0x007E/rcl/mechanical/housing.FCStd

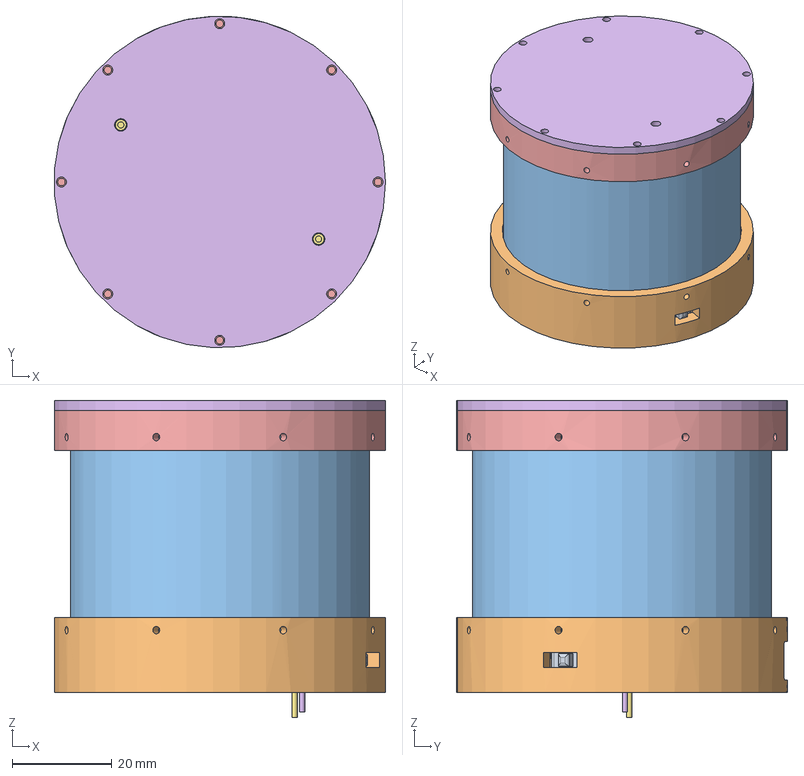
[picture p1: CAD file, 2026-05-14]
mechanical/housing.FCStd
66.3 x 66.3 x 63.5 mm
Pcb_e179
U2_SOT_563_2dd8ecf5d5b2
C7_C_1206_3216Metric_b50edff72533
D17_LED_RGB_5050_6_446c280b42f4
R8_R_1206_3216Metric_683208ab82f3
R7_R_1206_3216Metric_c8e4829b0dbe
R20_R_1206_3216Metric_ada6986ab1e3
U4_SOIC_14_39x87mm_P127mm_a823e2dd6a96
R6_R_1206_3216Metric_a43521a23db1
D8_LED_1206_3216Metric_441c9a4e21c6
R22_R_1206_3216Metric_ec401104cd5b
R2_R_1206_3216Metric_38918280b1d4
J3_PinSocket_1x05_P254mm_Vertical_10db449187f2
D10_LED_RGB_5050_6_a057058c2c85
D14_LED_RGB_5050_6_f9c46359ebbe
C5_CP_EIA_6032_28_Kemet_C_9ff8ca105aa5
C6_CP_EIA_6032_28_Kemet_C_5cea3e5c8aeb
D9_LED_1206_3216Metric_51ed994f9992
U1_MSOP_10_3x3mm_P05mm_71ae01295b95
D3_LED_1206_3216Metric_cbb3f32ba383
D16_LED_RGB_5050_6_b71b78d54b77
D15_LED_RGB_5050_6_33237c4f53fe
R26_R_1206_3216Metric_9c2edd1c9367
D7_LED_1206_3216Metric_bb91850a56bd
D12_LED_RGB_5050_6_03ddc8fedd98
R1_R_1206_3216Metric_1c8ffaa0bde6
D11_LED_RGB_5050_6_1851560dca97
C8_CP_EIA_6032_28_Kemet_C_c15ccf4b1ffd
Pins
Pins001
Sealant
wire
wire001
R3_R_1206_3216Metric_5ddc5bbf8b34
D13_LED_RGB_5050_6_6a2bdbbd2506
D2_D_MiniMELF_Standard_6b93bcc5f046
R27_R_1206_3216Metric_52032e25f07e
F2_Fuse_1206_3216Metric_555ae69b6f8a
C13_C_1206_3216Metric_f1310714ac0f
R25_R_1206_3216Metric_a714514fdd53
R5_R_1206_3216Metric_4461fe18ce72
C10_C_1206_3216Metric_f1c43b265332
C3_CP_EIA_3528_21_Kemet_B_289e8f7c64f1
C16_C_1206_3216Metric_33e90888eea0
C2_C_1206_3216Metric_edaf30bb730d
C4_C_1206_3216Metric_e27ebc430218
D1_D_SMA_fda0fc89879e
C12_C_1206_3216Metric_5ff6f1587083
C15_C_1206_3216Metric_d52032bb3cd0
R9_R_1206_3216Metric_4f6db5270b56
SW3_SW_SPST_PTS645_fdfa39aaf73e
J2_JST_S2B_PH_K_a3ec8615dd23
R13_R_1206_3216Metric_72071d534f4d
C19_C_1206_3216Metric_a9e1a73ff39b
C20_C_1206_3216Metric_c22b4fc6462b
D6_D_MiniMELF_Standard_ccd223f269fd
U3_SOIC_8_39x49mm_P127mm_1d457f73bb48
Q2_SOT_23_310fab92fd9c
C18_C_1206_3216Metric_0231d3197693
R15_R_1206_3216Metric_49b70c382772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
