0x007E/rcl/pcb/RCL.kicad_pcb

## KiCad design pcb/RCL.kicad_pcb (2026-06-05)

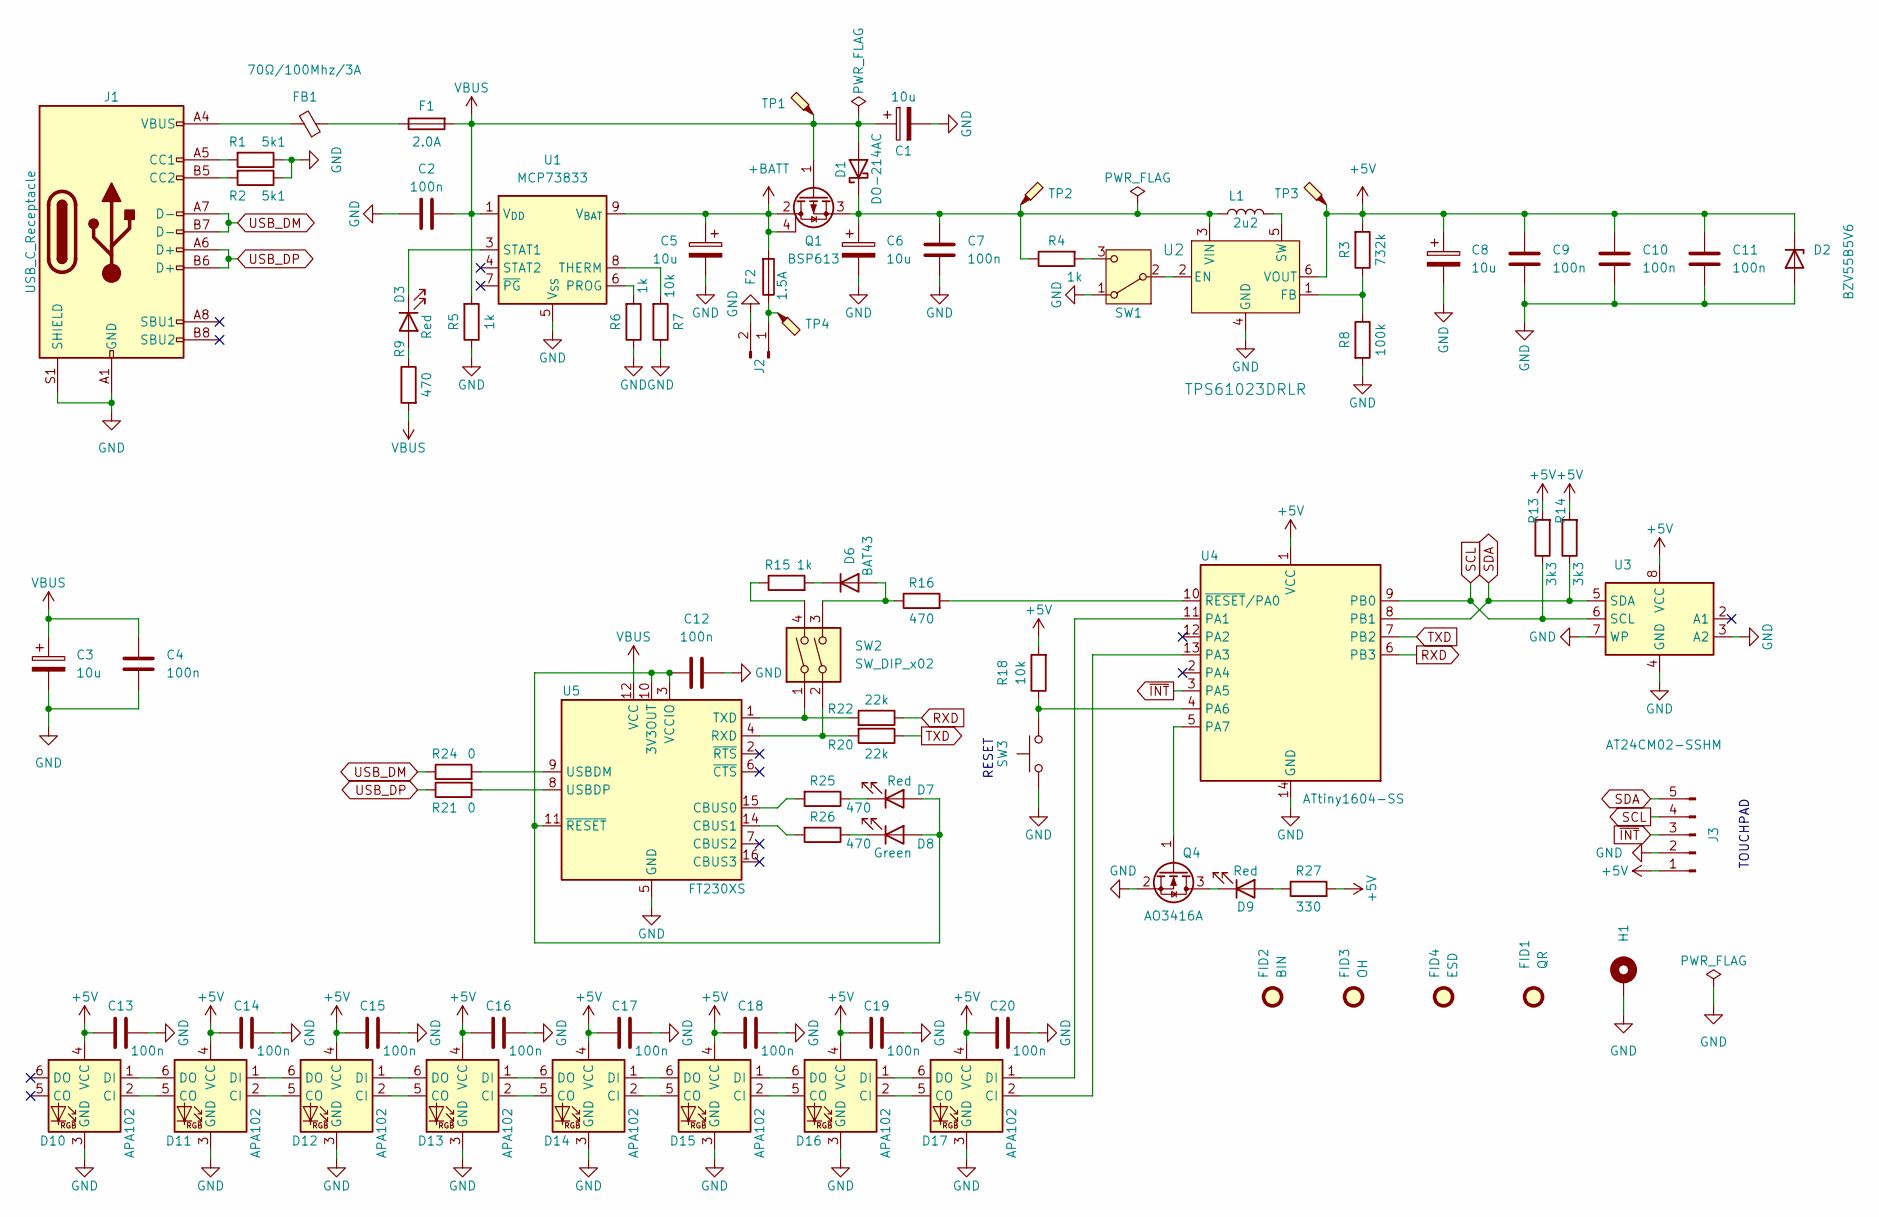
[picture p2: schematic RCL.kicad_sch, ${acronym} - ${title}]

Parts:
C1, C5, C6, C8: 10u; CP_EIA-6032-28_Kemet-C
C2, C4, C7, C9, C10, C11, C12, C13, C14, C15, C16, C17, C18, C19, C20: 100n; C_1206_3216Metric
C3: 10u; CP_EIA-3528-21_Kemet-B
D1: DO-214AC; D_SMA
D2: BZV55B5V6; D_MiniMELF
D3, D7, D9: Red; LED_1206_3216Metric
D6: BAT43; D_MiniMELF
D8: Green; LED_1206_3216Metric
D10, D11, D12, D13, D14, D15, D16, D17: APA102; LED_RGB_5050-6
F1: 2.0A; Fuse_1206_3216Metric
F2: 1.5A; Fuse_1206_3216Metric
FB1: 70Ω/100Mhz/3A; L_1206_3216Metric
FID1: QR; QR_0x007e_very_small
FID2: BIN; WEEE-Logo_4.2x6mm_SilkScreen
FID3: OH; OSHW-Logo2_7.3x6mm_SilkScreen
FID4: ESD; ESD-Logo_6.6x6mm_SilkScreen
H1: MountingHole_Pad; MountingHole_3.2mm_M3_DIN965_Pad
J1: USB_C_Receptacle; USB_C_Receptacle_GCT_USB4110
J2: Conn_01x02_Pin; JST_PH_S2B-PH-K_1x02_P2.00mm_Horizontal; DigiKey BC2AAAW-ND, 455-2266-ND, BXH-001T-P0.6-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
J3: Conn_01x05_Pin; PinSocket_1x05_P2.54mm_Vertical
L1: 2u2; L_Vishay_IFSC-1515AH_4x4x1.8mm
Q1: BSP613; SOT-223
Q4: AO3416A; SOT-23
R1, R2: 5k1; R_1206_3216Metric
R3: 732k; R_1206_3216Metric
R4, R5, R6, R15: 1k; R_1206_3216Metric
R7, R18: 10k; R_1206_3216Metric
R8: 100k; R_1206_3216Metric
R9, R16, R25, R26: 470; R_1206_3216Metric
R13, R14: 3k3; R_1206_3216Metric
R20, R22: 22k; R_1206_3216Metric
R21, R24: 0; R_0603_1608Metric; DigiKey RMCF0603ZT0R00CT-ND
R27: 330; R_1206_3216Metric
SW1: SW_SPDT; SW_SPDT_CK_JS102011SAQN
SW2: SW_DIP_x02; SW_DIP_SPSTx02_Slide_6.7x6.64mm_W8.61mm_P2.54mm_LowProfile
SW3: SW_Push; SW_SPST_PTS645
TP1, TP2, TP3, TP4: TestPoint_Probe; TestPoint_Pad_D1.0mm
U1: MCP73833; MSOP-10_3x3mm_P0.5mm
U2: TPS61023DRLR; SOT-563
U3: AT24CM02-SSHM; SOIC-8_3.9x4.9mm_P1.27mm
U4: ATtiny1604-SS; SOIC-14_3.9x8.7mm_P1.27mm
U5: FT230XS; SSOP-16_3.9x4.9mm_P0.635mm

Connections:
+5V: C8.1, C9.1, C10.1, C11.1, C13.2, C14.2, C15.2, C16.2, C17.2, C18.2, C19.2, C20.2, D2.1 (K), D10.4 (VCC), D11.4 (VCC), D12.4 (VCC), D13.4 (VCC), D14.4 (VCC), D15.4 (VCC), D16.4 (VCC), D17.4 (VCC), J3.1, R3.2, R13.2, R14.2, R18.2, R27.2, TP3.1, U2.6 (VOUT), U3.8 (VCC), U4.1 (VCC)
+BATT: C5.1, F2.2, Q1.2 (D), Q1.4 (D), U1.9 (V_{BAT}), U1.10 (V_{BAT})
GND: C1.2, C2.2, C3.2, C4.2, C5.2, C6.2, C7.2, C8.2, C9.2, C10.2, C11.2, C12.2, C13.1, C14.1, C15.1, C16.1, C17.1, C18.1, C19.1, C20.1, D2.2 (A), D10.3 (GND), D11.3 (GND), D12.3 (GND), D13.3 (GND), D14.3 (GND), D15.3 (GND), D16.3 (GND), D17.3 (GND), H1.1, J1.A1 (GND), J1.A12 (GND), J1.B1 (GND), J1.B12 (GND), J1.S1 (SHIELD), J2.2, J3.2, Q4.2 (S), R1.1, R2.1, R5.1, R6.1, R7.1, R8.2, SW1.1 (A), SW3.1, U1.5 (V_{SS}), U2.4 (GND), U3.3 (A2), U3.4 (GND), U3.7 (WP), U4.14 (GND), U5.5 (GND), U5.13 (GND)
unnamed: C6.1, C7.1, D1.1 (K), L1.1, Q1.3 (S), R4.1, TP2.1, U2.3 (VIN)
unnamed: D3.2 (A), R9.1
unnamed: D3.1 (K), U1.3 (STAT1)
unnamed: D6.2 (A), R16.1, SW2.3
unnamed: D6.1 (K), R15.2
unnamed: C12.1, D7.2 (A), D8.2 (A), U5.3 (VCCIO), U5.10 (3V3OUT), U5.11 (~RESET)
unnamed: D7.1 (K), R25.1
unnamed: D8.1 (K), R26.1
unnamed: D9.2 (A), R27.1
unnamed: D9.1 (K), Q4.3 (D)
unnamed: D10.2 (CI), D11.5 (CO)
unnamed: D10.1 (DI), D11.6 (DO)
unnamed: D11.2 (CI), D12.5 (CO)
unnamed: D11.1 (DI), D12.6 (DO)
unnamed: D12.2 (CI), D13.5 (CO)
unnamed: D12.1 (DI), D13.6 (DO)
unnamed: D13.2 (CI), D14.5 (CO)
unnamed: D13.1 (DI), D14.6 (DO)
unnamed: D14.2 (CI), D15.5 (CO)
unnamed: D14.1 (DI), D15.6 (DO)
unnamed: D15.2 (CI), D16.5 (CO)
unnamed: D15.1 (DI), D16.6 (DO)
unnamed: D16.2 (CI), D17.5 (CO)
unnamed: D16.1 (DI), D17.6 (DO)
unnamed: D17.2 (CI), U4.13 (PA3)
unnamed: D17.1 (DI), U4.11 (PA1)
unnamed: F1.1, FB1.1
unnamed: FB1.2, J1.A4 (VBUS), J1.A9 (VBUS), J1.B4 (VBUS), J1.B9 (VBUS)
unnamed: J1.A5 (CC1), R1.2
unnamed: J1.B5 (CC2), R2.2
unnamed: F2.1, J2.1, TP4.1
unnamed: Q4.1 (G), U4.5 (PA7)
unnamed: R15.1, SW2.4
unnamed: SW1.2 (B), U2.2 (EN)
unnamed: R4.2, SW1.3 (C)
unnamed: R6.2, U1.6 (PROG)
unnamed: R7.2, U1.8 (THERM)
unnamed: R3.1, R8.1, U2.1 (FB)
unnamed: L1.2, U2.5 (SW)
unnamed: R18.1, SW3.2, U4.4 (PA6)
unnamed: R16.2, U4.10 (~RESET/PA0)
unnamed: R25.2, U5.15 (CBUS0)
unnamed: R26.2, U5.14 (CBUS1)
unnamed: R20.2, SW2.2, U5.4 (RXD)
unnamed: R22.2, SW2.1, U5.1 (TXD)
unnamed: R24.2, U5.9 (USBDM)
unnamed: R21.2, U5.8 (USBDP)
RXD: R22.1, U4.6 (PB3)
SCL: J3.4, R13.1, U3.6 (SCL), U4.9 (PB0)
SDA: J3.5, R14.1, U3.5 (SDA), U4.8 (PB1)
TXD: R20.1, U4.7 (PB2)
USB_DM: J1.A7 (D-), J1.B7 (D-), R24.1
USB_DP: J1.A6 (D+), J1.B6 (D+), R21.1
VBUS: C1.1, C2.1, C3.1, C4.1, D1.2 (A), F1.2, Q1.1 (G), R5.2, R9.2, TP1.1, U1.1 (V_{DD}), U1.2 (V_{DD}), U5.12 (VCC)
~INT: J3.3, U4.3 (PA5)

Notes on the sheet:
TOUCHPAD
RESET

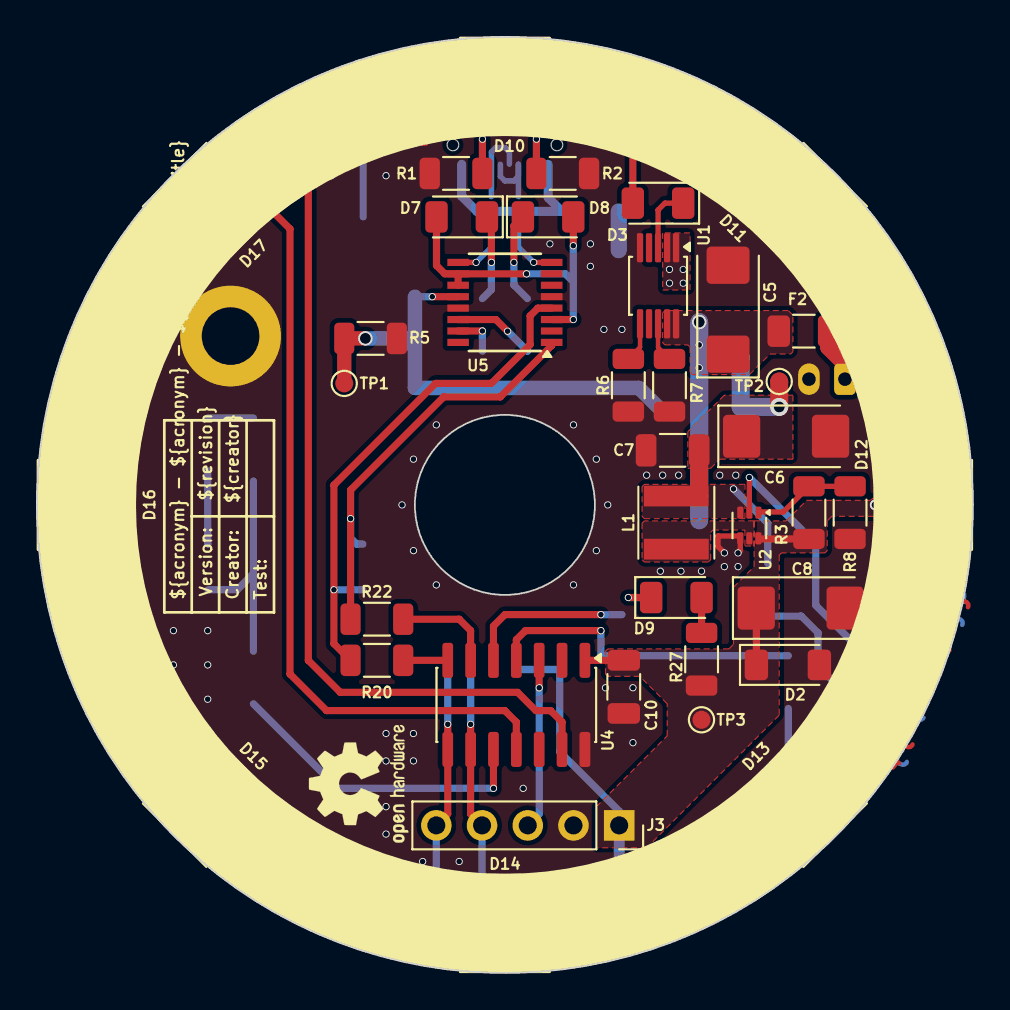
[picture p3: board RCL.kicad_pcb from above]

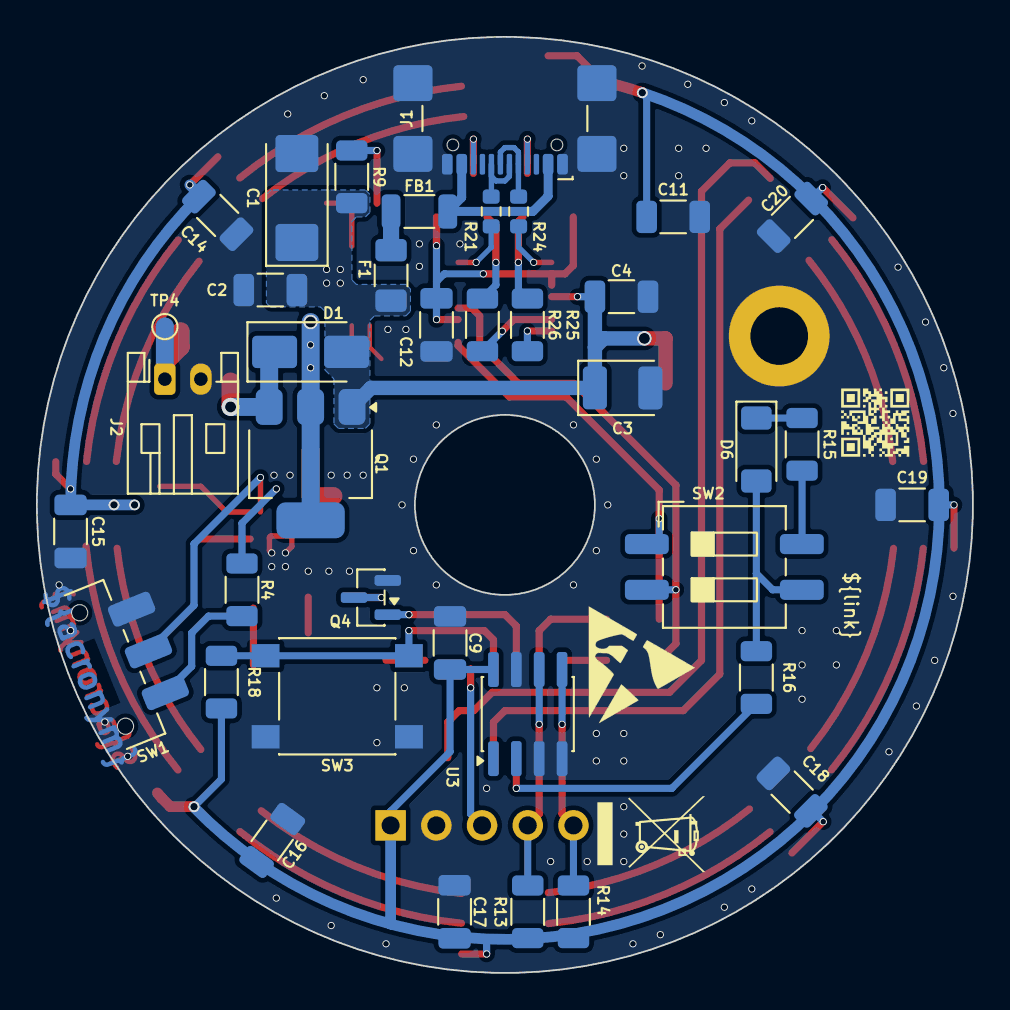
[picture p4: board RCL.kicad_pcb from below]

Board: 2 copper layers, 52.0 x 52.0 mm, 82 parts (41 on the bottom side), 58 nets.
