0x007E/rcl/(commit log)

2026-05-14 Move pcb position on sheet
    [RCL.kicad_pcb]
2026-05-14 Optimize fabrication layer
    [RCL.kicad_pcb]
2026-05-14 Optimize parameter properties
    [housing.FCStd]
2026-05-22 Add missing vendor(id)
    [RCL.kicad_pcb, RCL.kicad_sch]
2026-05-27 Rename/Add/Remove bom fields
    [RCL.kicad_pcb, RCL.kicad_sch]
2026-06-04 Change MCP2221A to FT230X
    [RCL.kicad_pcb, RCL.kicad_sch]
2026-06-05 Optimize +3V3 signal
    [RCL.kicad_pcb, RCL.kicad_sch]
