0x007E/rcl/(notices)

Notices in the files:
README.md:
License CC By-NC-SA
parts and their libraries:
license: CC BY-NC-SA 4.0
